CodeIsNotEvil/roboter_platform/Pinzuordnung_Fernsteuerung.txt

Funkmodul:

	-CE				= A2
	-IRQ				= A1
	-SPI				= HW SPI vorgabe (D11 bis D13)
	-CSN				= A3
