CodeIsNotEvil/roboter_platform/Latex/main.pdf

# Open Source Roboter Plattform

### Lukas Reichwein Yves Ehrlich Nick Gnoevoj

### University of Applied Science Fulda — 23. Januar 2020

## Inhaltsverzeichnis

1 Vorwort | 2
2 Funksteuereung | 3
3 SPI | 4
4 Arduino Libaries | 5
5 Joystick Integration | 6
6 Motorsteuerung | 7
7 Thermosensor | 8
8 Ultraschallsensor | 9
9 Beispiele für Spezielle LaTeX Strukturen | 10

## 1 Vorwort

Motivation Eine Platform bieten ist etwas was momentan sehr stark im Trend liegt, sei es im Software oder im Hardware bereich. Im Softwarebereich zeigt sich dies meist durch opensource libaries, welche möglichst varriable einsetzbaren Code für jeden frei zugänglich machen.
Ein solches Projekt war auch von einem der Projektmitglieder (Yves Ehrlich) als Privates Projekt geplant und so kahm die Überlegung dies innerhalb des Modules Embedded Networking zu wählen.

Basis des Projektes Als Basis des Projektes dient einer schon bereits von Yves Ehrlich angefertigter Arduino Nano Shield samt Code, [1] welcher als Fernsteuerung verwendet wird.

Ziel des Projektes Ziel des Projektes ist eine ferngesteuerte, OpenSource basierende Roboterplatform.

## 2 Funksteuereung

Wie schon zuvor erwähnt wird für die Basis der Funksteuerung das Arduino Shield verwendet, welches mit einem RF24 Chip erweitert wurde.

### 2.1 RF24

## 3 SPI

## 4 Arduino Libaries

## 5 Joystick Integration

## 6 Motorsteuerung

## 7 Thermosensor

## 8 Ultraschallsensor

## 9 Beispiele für Spezielle LaTeX Strukturen

Info: benutze den Info block um wichtige informationen hervorzuheben.

i

Algorithm 1: FastTwoSum
Input: (a, b), two floating-point numbers Result: (c, d), such that a + b = c + d

if |b| > |a| then
exchange a and b ;
end
c ← a + b ;
z ← c − a ;
d ← b − z ;
return (c, d) ;

# ! / usr / bin / python

import sys
sys . stdout . write ( " Hello ␣ World !\ n " )

hello.py

Command Line

$ chmod +x hello.py
$ ./hello.py

Hello World!S

Notice: Warungen könnten auch nützlich sein, immerhin braucht der RF24 3.3V und nicht 5V

!

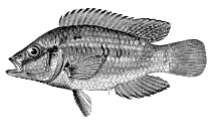
[picture p23: figure]

## Literatur

[1] Yves Ehrlich. https://gitlab.informatik.hs-fulda.de/fdai5253/nanogame. Repository Nano Game.
