CodeIsNotEvil/roboter_platform/Latex/images/motorhalterung.png

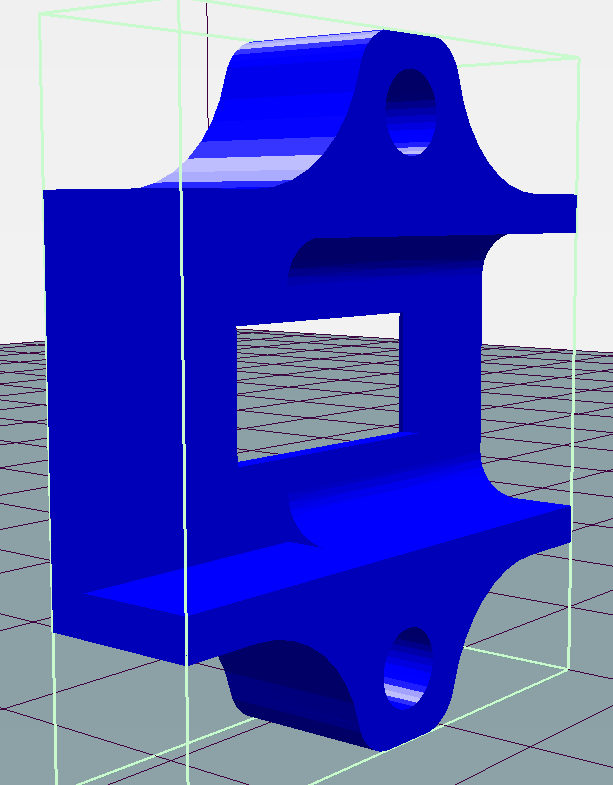
Latex/images/motorhalterung.png
