CodeIsNotEvil/roboter_platform/gedruckte Bauteile/motorhalterung.stl

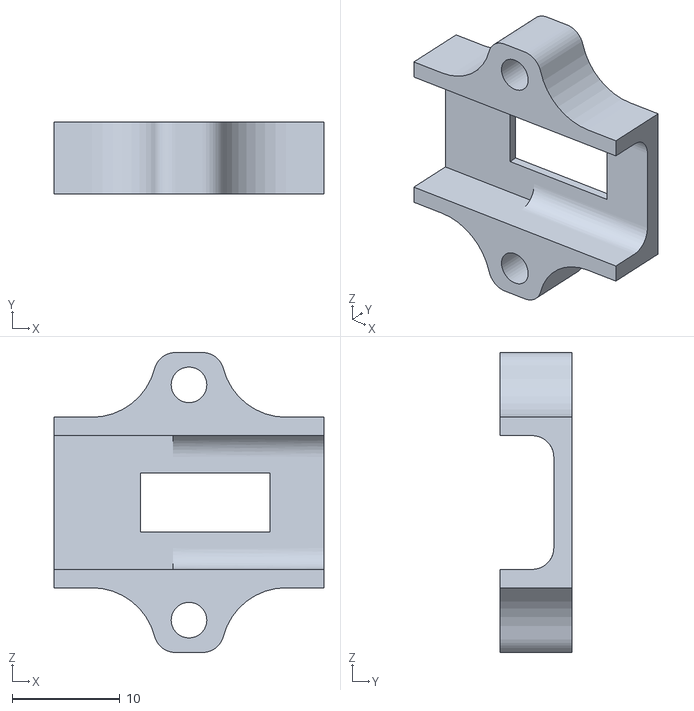
[picture p27: CAD file, 2020-02-12]
gedruckte Bauteile/motorhalterung.stl
25.0 x 6.70 x 27.8
