CodeIsNotEvil/roboter_platform/gedruckte Bauteile/joystick_halterung.stl

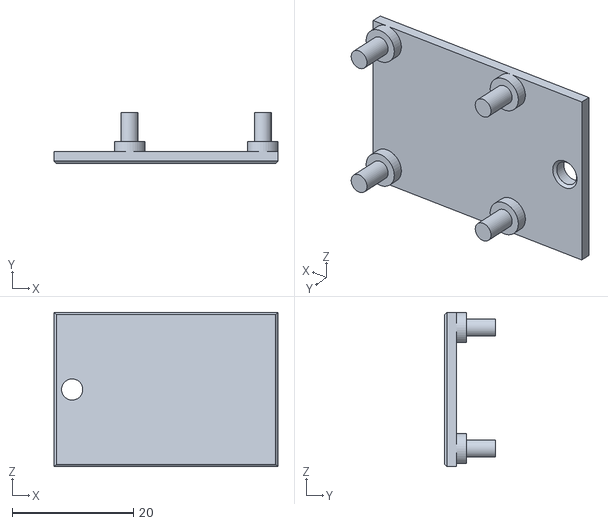
[picture p28: CAD file, 2020-02-12]
gedruckte Bauteile/joystick_halterung.stl
37.0 x 8.40 x 25.5
