CodeIsNotEvil/roboter_platform/gedruckte Bauteile/akkuhalterung.stl

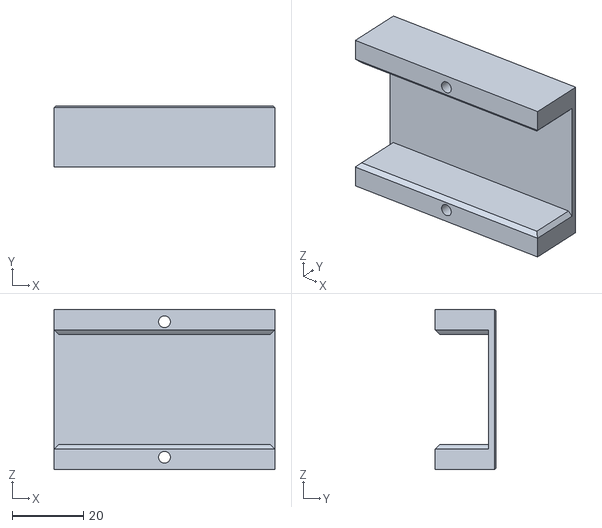
[picture p29: CAD file, 2020-02-12]
gedruckte Bauteile/akkuhalterung.stl
62.0 x 17.0 x 45.0
