CodeIsNotEvil/roboter_platform/gedruckte Bauteile/teller.stl

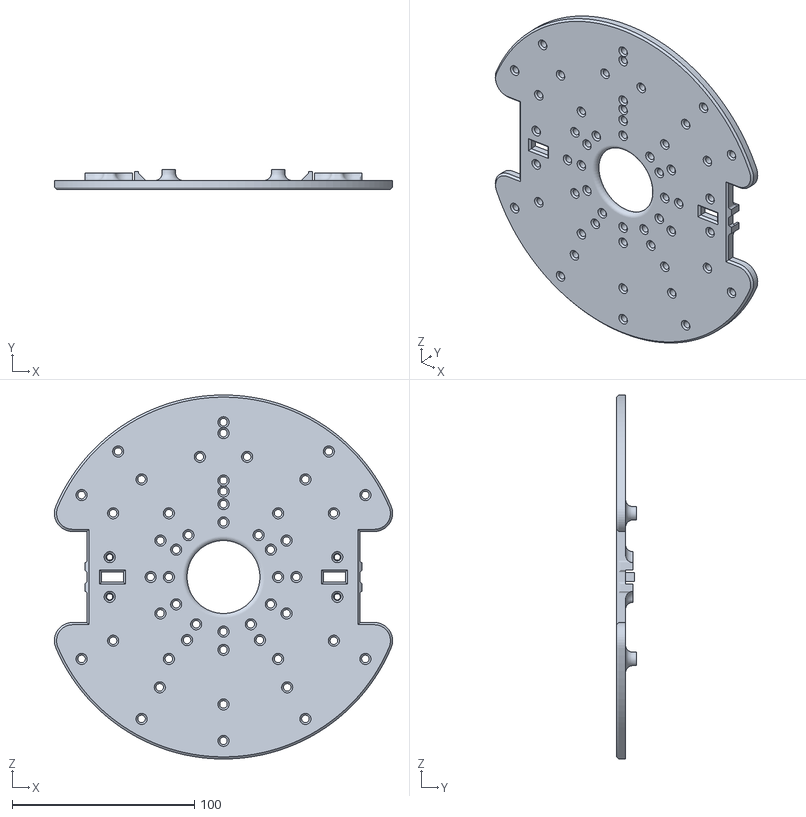
[picture p30: CAD file, 2020-02-12]
gedruckte Bauteile/teller.stl
185.8 x 11.0 x 199.9
