CodeIsNotEvil/roboter_platform/gedruckte Bauteile/schalterhalterung.stl

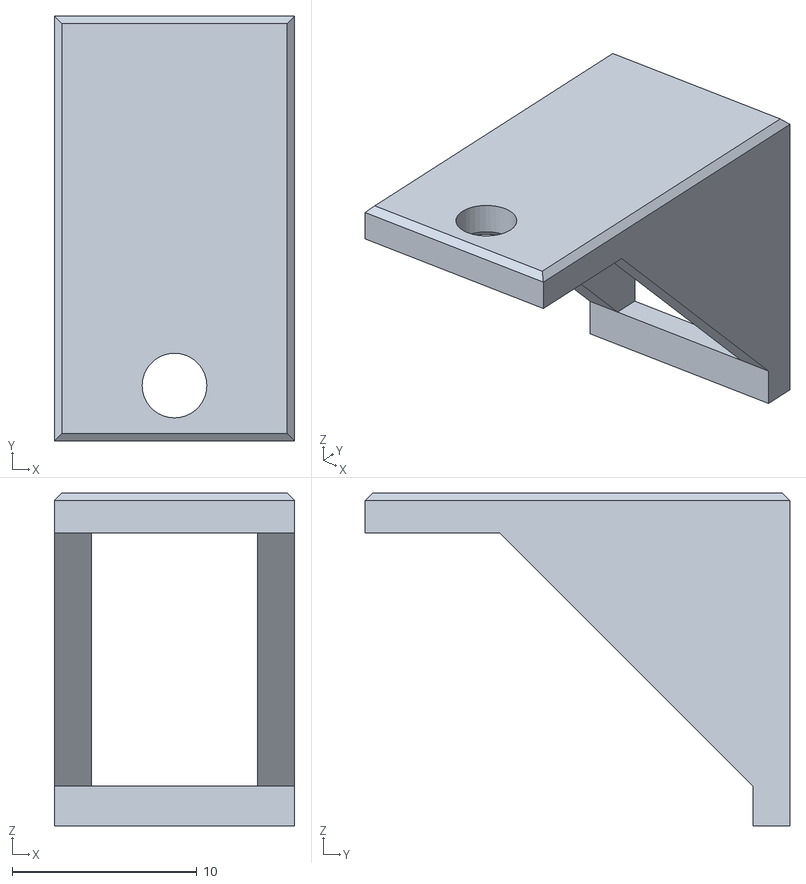
[picture p31: CAD file, 2020-02-12]
gedruckte Bauteile/schalterhalterung.stl
13.0 x 23.0 x 18.0
