CodeIsNotEvil/roboter_platform/gedruckte Bauteile/hc-sr04_halterung_rahmen.stl

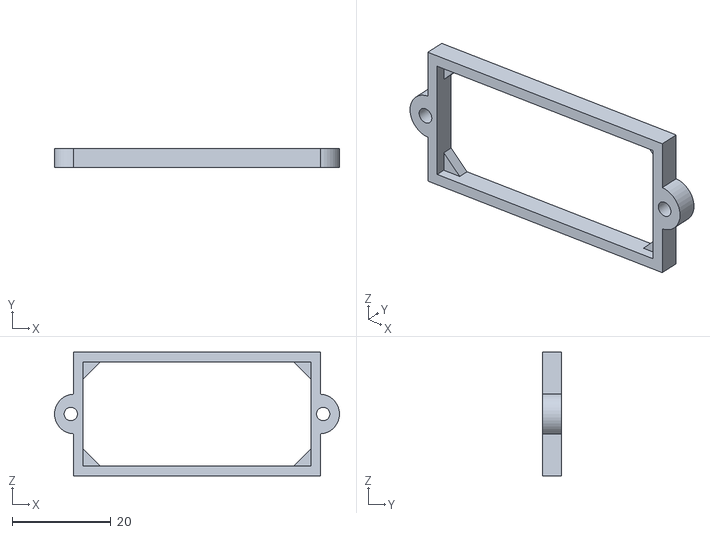
[picture p32: CAD file, 2020-02-12]
gedruckte Bauteile/hc-sr04_halterung_rahmen.stl
57.6 x 3.80 x 25.0
