CodeIsNotEvil/roboter_platform/gedruckte Bauteile/hc-sr04_halterung_winkel.stl

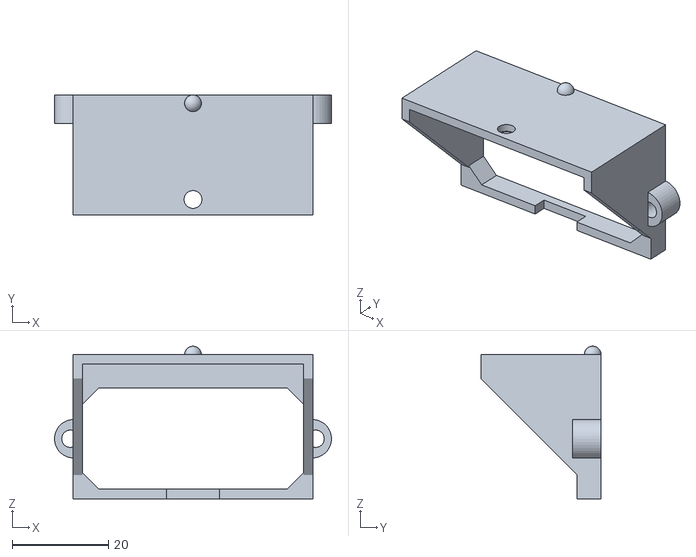
[picture p33: CAD file, 2020-02-12]
gedruckte Bauteile/hc-sr04_halterung_winkel.stl
57.6 x 25.0 x 31.8
