CodeIsNotEvil/roboter_platform/gedruckte Bauteile/rad_3_2mm.stl

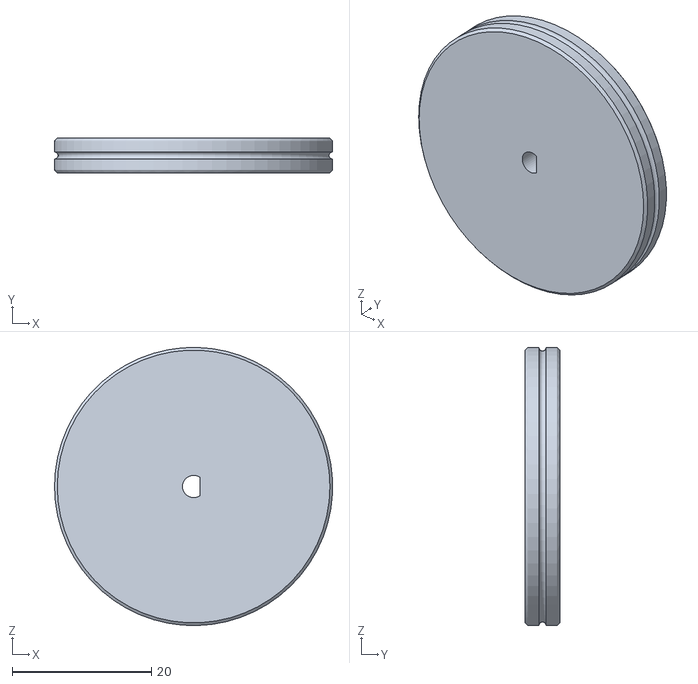
[picture p34: CAD file, 2020-02-12]
gedruckte Bauteile/rad_3_2mm.stl
40.0 x 5.00 x 40.0
