CodeIsNotEvil/roboter_platform/gedruckte Bauteile/kugelrad_v2.stl

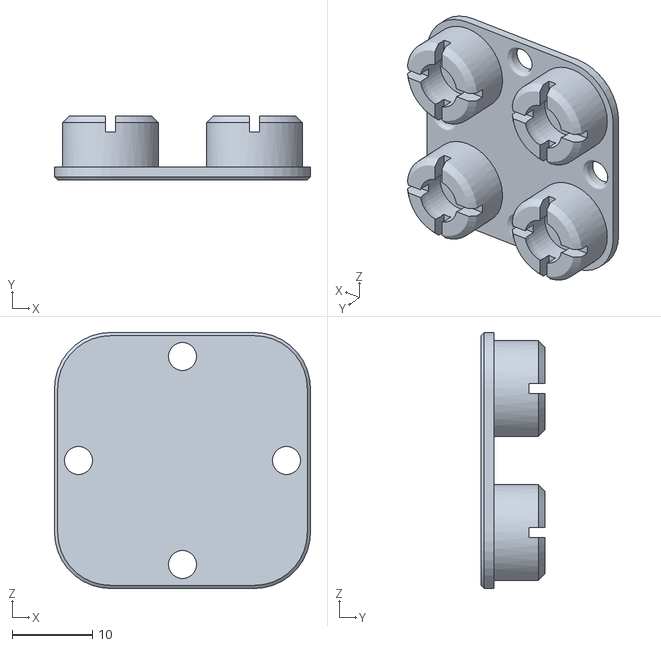
[picture p35: CAD file, 2020-02-12]
gedruckte Bauteile/kugelrad_v2.stl
32.0 x 8.00 x 32.0
