CodeIsNotEvil/roboter_platform/(list of files, drawings)

Other design files:
Layout/miniRob.lay6
