CodeIsNotEvil/roboter_platform/(commit log)

2019-11-04 Anforderungen und Spezifikationen formuliert (unvollstaendig)
2019-11-04 Anforderungen und Spez. ergaenzt
2019-11-04 Servo Datenblatt
2019-12-12 Pinzuordnungen fuer Roboter und Fernsteuerung
2020-01-12 aktueller Code für Fernsteuerung und Roboter
2020-01-14 sollte soweit das tun, was vorgesehen ist, allerdings nicht Glitch free
    [Joystick_ohne_float.ino]
2020-01-15 Layout hinzugefuegt
    [miniRob.lay6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]
2020-01-18 higest and lowest values of a motor should be used instead of 255 and -255
2020-01-23 Added section placeholders and wiriteing something at Vorwort
2020-01-28 rearanged Project to add JoystickSteuerung and outcomment the fahrsteuerung due to missing methodes in libaries
    [JoystickSteuerung.ino, _main.ino, fahrsteuerung_old.ino]
2020-01-28 Integrated lib into Project and fixed constantly showing 255 as PWMValue at no joystick modulation
    [JoystickSteuerung.ino, _main.ino, fahrsteuerung_old.ino]
2020-02-01 Repo des als Fernsteuerung genutzten Projekts hinzugefuegt
2020-02-02 Added measurement of temperature and distance.
2020-02-02 Added missing commands for measurements.
    [JoystickSteuerung.ino, _main.ino, miniRobotRC.ino]
2020-02-05 Motortreiber Lib added
2020-02-07 LCD Darstellung geaendert, jetzt alle 100ms refresh der 6 Zeilen
2020-02-08 Fixed temperature measurement.
2020-02-08 Temperature is now shown on the lcd! Amazing! Wow, very cool.
2020-02-08 Roboter should now stop if the distance is lower than 20cm
2020-02-08 Temperature measurement now worls more reliable.
2020-02-09 solved some left over merge conflicts
    [JoystickSteuerung.ino, _main.ino, fahrsteuerung_old.ino, joystick.ino]
2020-02-11 Added documentation for super sonic sensor.
2020-02-12 STLs ergaenzt
    [akkuhalterung.stl, hc-sr04_halterung_rahmen.stl, hc-sr04_halterung_winkel.stl, joystick_halterung.stl, kugelrad_v2.stl, motorhalterung.stl, rad_3_2mm.stl, schalterhalterung.stl]
2020-02-12 Fixed some formating issues on the dallas and the super sonic sensor.
2020-02-12 Timeout fuer Temperaturmessung added
2020-02-12 Updated documentation on super sonic sensor.
2020-02-13 PWM added
